Ttreintaysiete/cacerolada/README.md

# cacerolada autómata
Este proyecto trata de diseñar y fabricar los componentes necesarios para poder crear una cacerolada electrónica autómata.

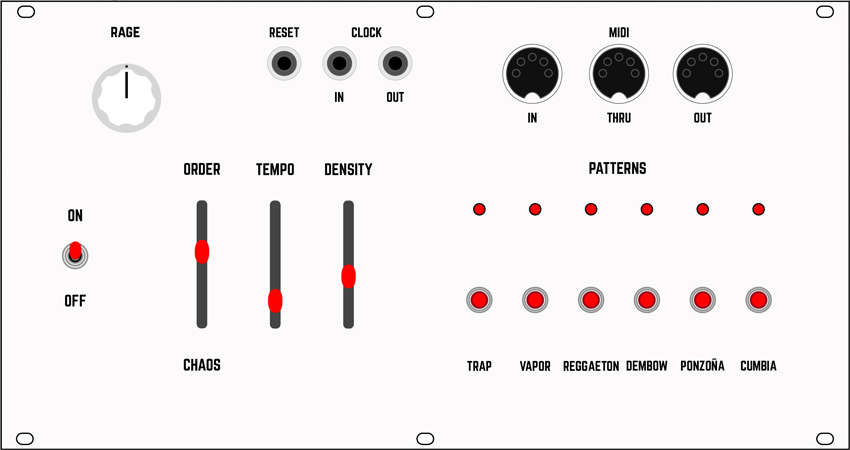
[picture p1: controlador_atril.jpg]
controlador_atril
