Ttreintaysiete/cacerolada/midi_solenoides/README.md

# MIDI to Solenoid

One octave arduino based midi to soleoid. 

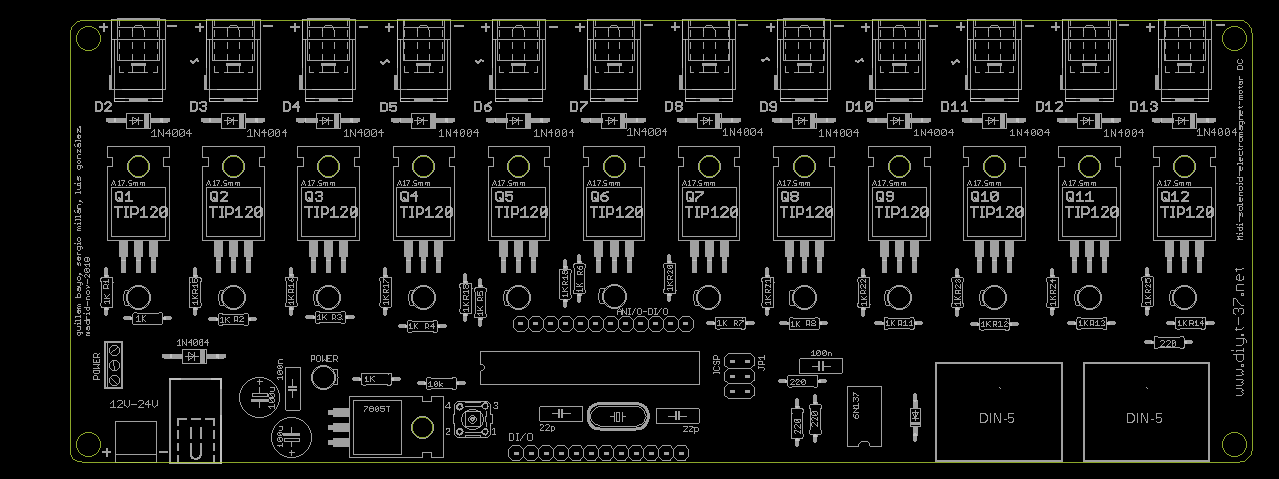
[picture p2: midi_solenoides/hardware/Pcb.png]
pcb

PCB

#

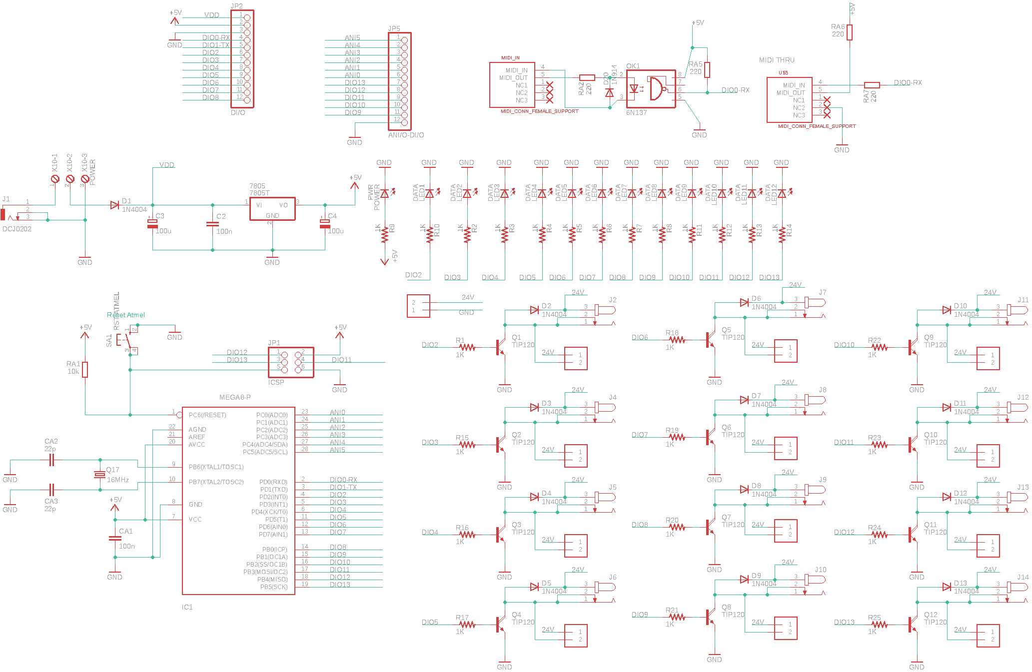
[picture p3: midi_solenoides/hardware/midi_solenoids_schematic.png]
schematic

Schematic

#

- [BOM](https://docs.google.com/spreadsheets/d/1d-w44R-xqymzVt59jLZTZCNicCAste95suxFi2tH_vA/edit?usp=sharing).

- [Mouser project](https://www.mouser.es/ProjectManager/ProjectDetail.aspx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).

#
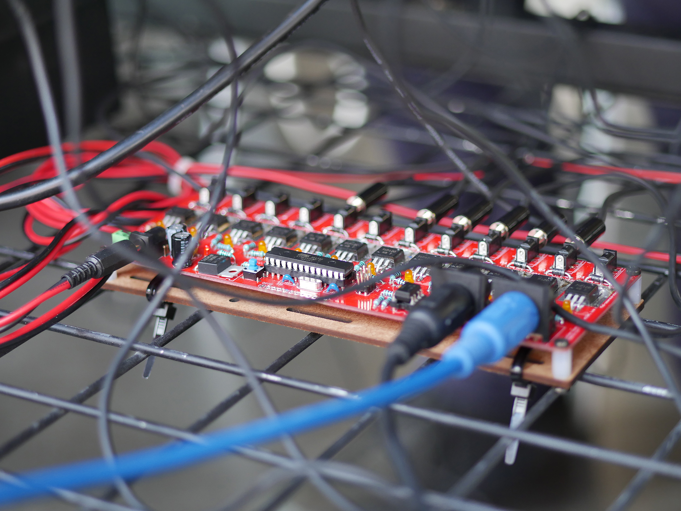
[picture p4: midi_solenoides/documentation/midi solenoids.JPG]
Automáticas


#
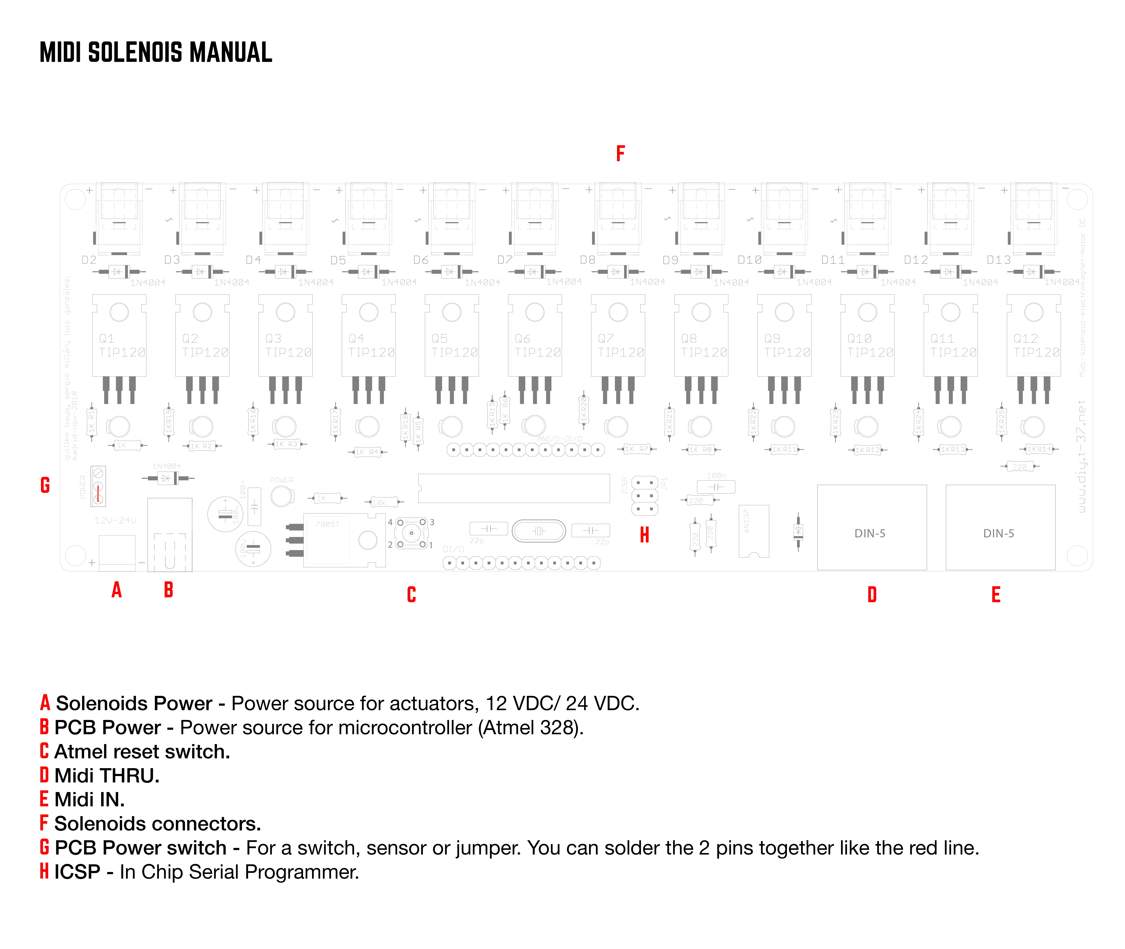
[picture p5: midi_solenoides/documentation/midi-solenoides_manual.jpg]
Manual
