Ttreintaysiete/cacerolada/midi_solenoides/hardware/midi-solenoids_BOM.xlsx

mouser | Qty | Value | Device | Package | Parts | Description
279-LR1F220R (https://www.mouser.es/ProductDetail/279-LR1F220R) | 4 | 220 | R-EU_0204/7 | 0204/7 | RA2, RA5, RA6, RA7 | RESISTOR, European symbol
279-LR1F91K (https://www.mouser.es/ProductDetail/TE-Connectivity-Holsworthy/LR1F1K0?qs=ip69W3eHERVhMxNSZkerTg%3D%3D) | 25 | 1K |  | 0204/7 | R1, R2, R3, R4, R5, R6, R7, R8, R9, R10, R11, R12, R13, R14, R15, R16, R17, R18, R19, R20, R21, R22, R23, R24, R25 | RESISTOR, American symbol
279-LR1F10K (https://www.mouser.es/ProductDetail/279-LR1F10K) | 1 | 10k |  | 0204/7 | RA1 | RESISTOR, European symbol
810-FK18C0G1H220J (https://www.mouser.es/ProductDetail/Vishay-BC-Components/K220J15C0GF53L2?qs=k6LumrLTTeWv6vqIDyH76Q%3D%3D) | 2 | 22p |  | C050-025X075 | CA2, CA3 | CAPACITOR, European symbol
594-K104K15X7RF53L2 (https://www.mouser.es/ProductDetail/594-K104K15X7RF53L2) | 2 | 100n | C-EU050-025X075 | C050-025X075 | C2, CA1 | CAPACITOR, European symbol
80-ESK107M050AH1AA (https://www.mouser.es/ProductDetail/232-35YXJ100M6.3X11) | 2 | 100u | CPOL-EUE2.5-7 | E2,5-7 | C3, C4 | POLARIZED CAPACITOR, European symbol
559-FOXS160-20-LF (https://www.mouser.es/ProductDetail/559-FOXS160-20-LF) | 1 | 16MHz |  | HC49/S | Q17 | CRYSTAL
863-1N4004RLG (https://www.mouser.es/ProductDetail/863-1N4004RLG) | 13 | 1N4004 | 1N4004 | DO41-10 | D1, D2, D3, D4, D5, D6, D7, D8, D9, D10, D11, D12, D13 | DIODE
512-1N4148 (https://www.mouser.es/ProductDetail/512-1N4148) | 1 | 1N4148/1N914 |  |  | D20 | DIODE
782-6N137 (https://www.mouser.es/ProductDetail/782-6N137) | 1 | 6N137 | 6N137 | DIL08 |  | MOTOROLA OPTO COUPLER
863-MC7805ACTG (https://www.mouser.es/ProductDetail/863-MC7805ACTG) | 1 | 7805T | 7805T | TO220H | 7805 | Positive VOLTAGE REGULATOR
859-LTL-1CHA (https://www.mouser.es/ProductDetail/Lite-On/LTL-1CHA?qs=ImLoyPzIOkVNGwHp4Bb3zg%3D%3D) | 12 | ORANGE | HLMP-M | LED4MM | LED1, LED2, LED3, LED4, LED5, LED6, LED7, LED8, LED9, LED10, LED11, LED12 | 4mm Flat Top LED
859-LTL-4211N (https://www.mouser.es/ProductDetail/Lite-On/LTL-4211N?qs=sGAEpiMZZMt82OzCyDsLFCqCEFs1vlXtp6U1B4h4WV0%3D) | 1 | RED | HLMP-M | LED4MM | LED POWER | 4mm Flat Top LED
161-0504-28A-E (https://www.mouser.es/ProductDetail/Kobiconn/161-0504-28A-E) | 2 | MIDI_CONN_FEMALE_SUPPORT | MIDI_CONN_FEMALE_SUPPORT | DIN_5_FEMALE_SUPPORT | MIDI_IN, U$5
649-175024-G01-20ULF (https://www.mouser.es/ProductDetail/Amphenol-FCI/10075024-G01-02LF?qs=QCVd87KtmY0fSOOW6apw5Q%3D%3D) | 1 | ICSP | PINHD-2X3 | 2X03 | JP1 | PIN HEADER
556-ATMEGA328P-PU (https://www.mouser.es/ProductDetail/556-ATMEGA328P-PU) | 1 | MEGA328 P-PU | MEGA328 P-PU | DIL28-3 | IC1 | MICROCONTROLLER
642-MJTP1234 (https://www.mouser.es/ProductDetail/Apem/MJTP1234?qs=ooeArD5nza%2FPPeZ%252B87mqiQ%3D%3D) | 1 | RST-ATMEL | 10-XX | B3F-10XX | SA1 | OMRON SWITCH
490-PJ-002A (https://www.mouser.es/ProductDetail/490-PJ-002A) | 13 | DCJ0202 | JACK-PLUG0 | DCJ0202 | J1, J2, J4, J5, J6, J7, J8, J9, J10, J11, J12, J13, J14 | DC POWER JACK
710-691214110002S (https://www.mouser.es/ProductDetail/710-691214110002S) | 1 | 1X2-3.5MM | 1X2-3.5MM | 1X2-3.5MM | 12V-24V, J15, J16, J17, J18, J19, J20, J21, J22, J23, J24, J25, J26 | 3.5mm Terminal block
511-TIP120 (https://www.mouser.es/ProductDetail/STMicroelectronics/TIP120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) | 12 | TIP120 | TIP120 | TO220AH | Q1, Q2, Q3, Q4, Q5, Q6, Q7, Q8, Q9, Q10, Q11, Q12 | NPN DARLINGTON TRANSISTOR
649-67997-410HLF (https://www.mouser.es/ProductDetail/649-67997-410HLF) | 1 | POWER | MPT3 | 3POL254 | X10 | PHOENIX CONNECTOR
