Ttreintaysiete/cacerolada/midi_solenoides/hardware/midi-solenoids_support.dxf

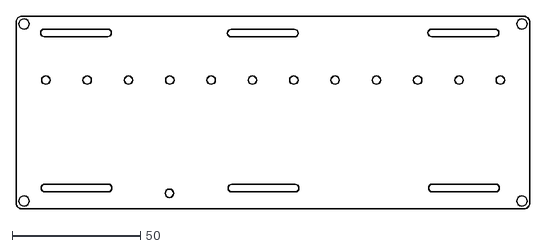
[picture p6: CAD file, 2020-09-06]
midi_solenoides/hardware/midi-solenoids_support.dxf
200.0 x 75.0
