Ttreintaysiete/cacerolada/midi_solenoides/documentation/midi-solenoides_manual.pdf

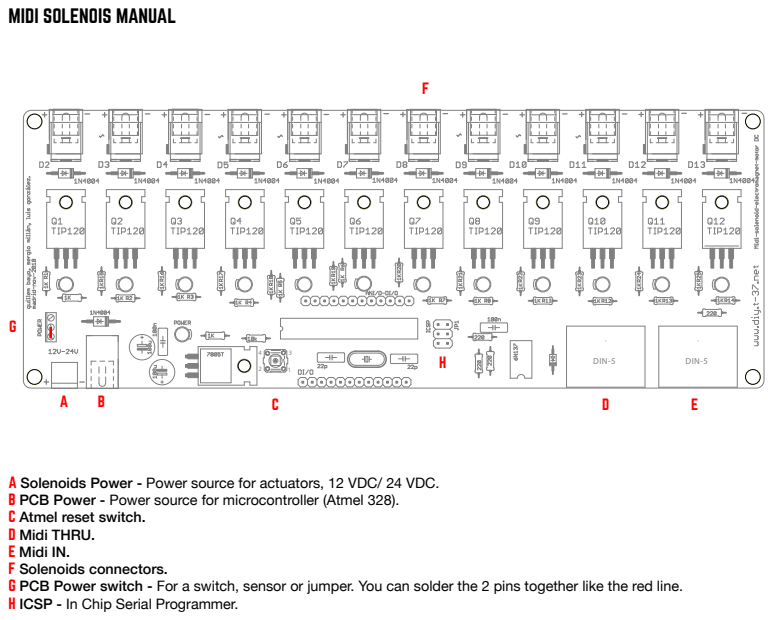
[picture p7: page 1]
DIN-5; DIN-5 2

MIDI SOLENOIS MANUAL

A Solenoids Power - Power source for actuators, 12 VDC/ 24 VDC.
B PCB Power - Power source for microcontroller (Atmel 328).
C Atmel reset switch.
D Midi THRU.
E Midi IN.
F Solenoids connectors.
G PCB Power switch - For a switch, sensor or jumper. You can solder the 2 pins together like the red line.
H ICSP - In Chip Serial Programmer.
