Ttreintaysiete/cacerolada/controlador/DRUMNBASS.h

//KICS
extern const byte D2[6][16]={
		{255,170,0  ,255,0  ,255,0  ,0  ,255,0  ,0  ,255,0  ,255,0  ,0  	},
		{255,0  ,0  ,80  ,0  ,255,255,0  ,0  ,0  ,0  ,0  ,255,0  ,0  ,0  	},
		{255,0  ,0  ,0  ,0  ,0  ,0  ,0  ,170,255,0  ,255,0  ,0  ,170,80  	},
		{255,0  ,170  ,0  ,255,0  ,0  ,0  ,255,0  ,0  ,0  ,255,0  ,170  ,0  	},
		{255,0  ,80  ,0  ,255,0  ,0  ,170  ,255,0  ,0  ,0  ,255,0  ,0  ,0  	},
		{255,0  ,0  ,0  ,255,0  ,0  ,0  ,255,0  ,0  ,170  ,255,0  ,0  ,80  	}
	};

// SNARE
extern const byte D3[6][16]={
		{0  ,0  ,0  ,0  ,255,0  ,0  ,0  ,0  ,0  ,0  ,255  ,0  ,0  ,0  ,0  	},
		{0  ,0  ,0  ,0  ,255,0  ,0  ,0  ,0  ,0  ,0  ,255,0  ,0  ,0  ,0  	},
		{0  ,0  ,0  ,0  ,255,0  ,0  ,0  ,0  ,0  ,0  ,255,0  ,0  ,0  ,0  	},
		{0  ,0  ,0  ,255,0  ,0  ,255,0  ,0  ,0  ,0  ,255,0  ,0  ,255,0  	},
		{0  ,0  ,0  ,0  ,255,0  ,0  ,0  ,0  ,0  ,0  ,255,0  ,0  ,0  ,0  	},
		{0  ,0  ,255,0  ,0  ,0  ,255,0  ,0  ,0  ,255,0  ,0  ,0  ,255,0  	}
};

// CLAP
extern const byte D4[6][16]={
		{0  ,0  ,0  ,0  ,170,0  ,0  ,0  ,0  ,0  ,0  ,255,0  ,0  ,170,0  	},
		{255  ,0  ,0  ,0  ,0  ,0  ,0  ,0  ,0  ,0  ,0  ,0  ,0  ,0  ,0  ,0  	},
		{0  ,0  ,170,0  ,255,0  ,0  ,0  ,0  ,0  ,0  ,255,0  ,0  ,0  ,0  	},
		{0  ,0  ,0  ,0  ,255,0  ,0  ,0  ,0  ,0  ,0  ,0  ,0  ,0  ,170  ,0  	},
		{255,0  ,0  ,0  ,255,0  ,0  ,0  ,255,0  ,0  ,255,0  ,0  ,0  ,0  	},
		{0  ,0  ,170,0  ,0  ,0  ,255,0  ,0  ,0  ,170,0  ,0  ,0  ,255,0  	}

};

//HHOPEN
extern const byte D5[6][16]={
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
		{0  ,0  ,50 ,100,0  ,0  ,0  ,0  ,0  ,0  ,0  ,0  ,0  ,0  ,0  ,0  	},
		{0  ,0  ,50 ,30 ,0  ,0  ,0  ,0  ,0  ,0  ,0  ,0  ,0  ,0  ,0  ,0  	},
		{0  ,0  ,0  ,100,0  ,0  ,0  ,0  ,0  ,0  ,0  ,0  ,0  ,0  ,0  ,0  	},
		{0  ,0  ,0  ,0  ,100,0  ,0  ,0  ,0  ,0  ,0  ,0  ,0  ,0  ,0  ,0  	}
};	
